CoretechR/ESP32-WiFi-Robot/README.md

# ESP32-WiFi-Robot
ESP32 Powered Video Streaming Robot

My image

Python is needed to convert the website file from HTML to a single string and back.
