CoretechR/ESP32-WiFi-Robot/Eagle Files/ESP32botV1.pdf

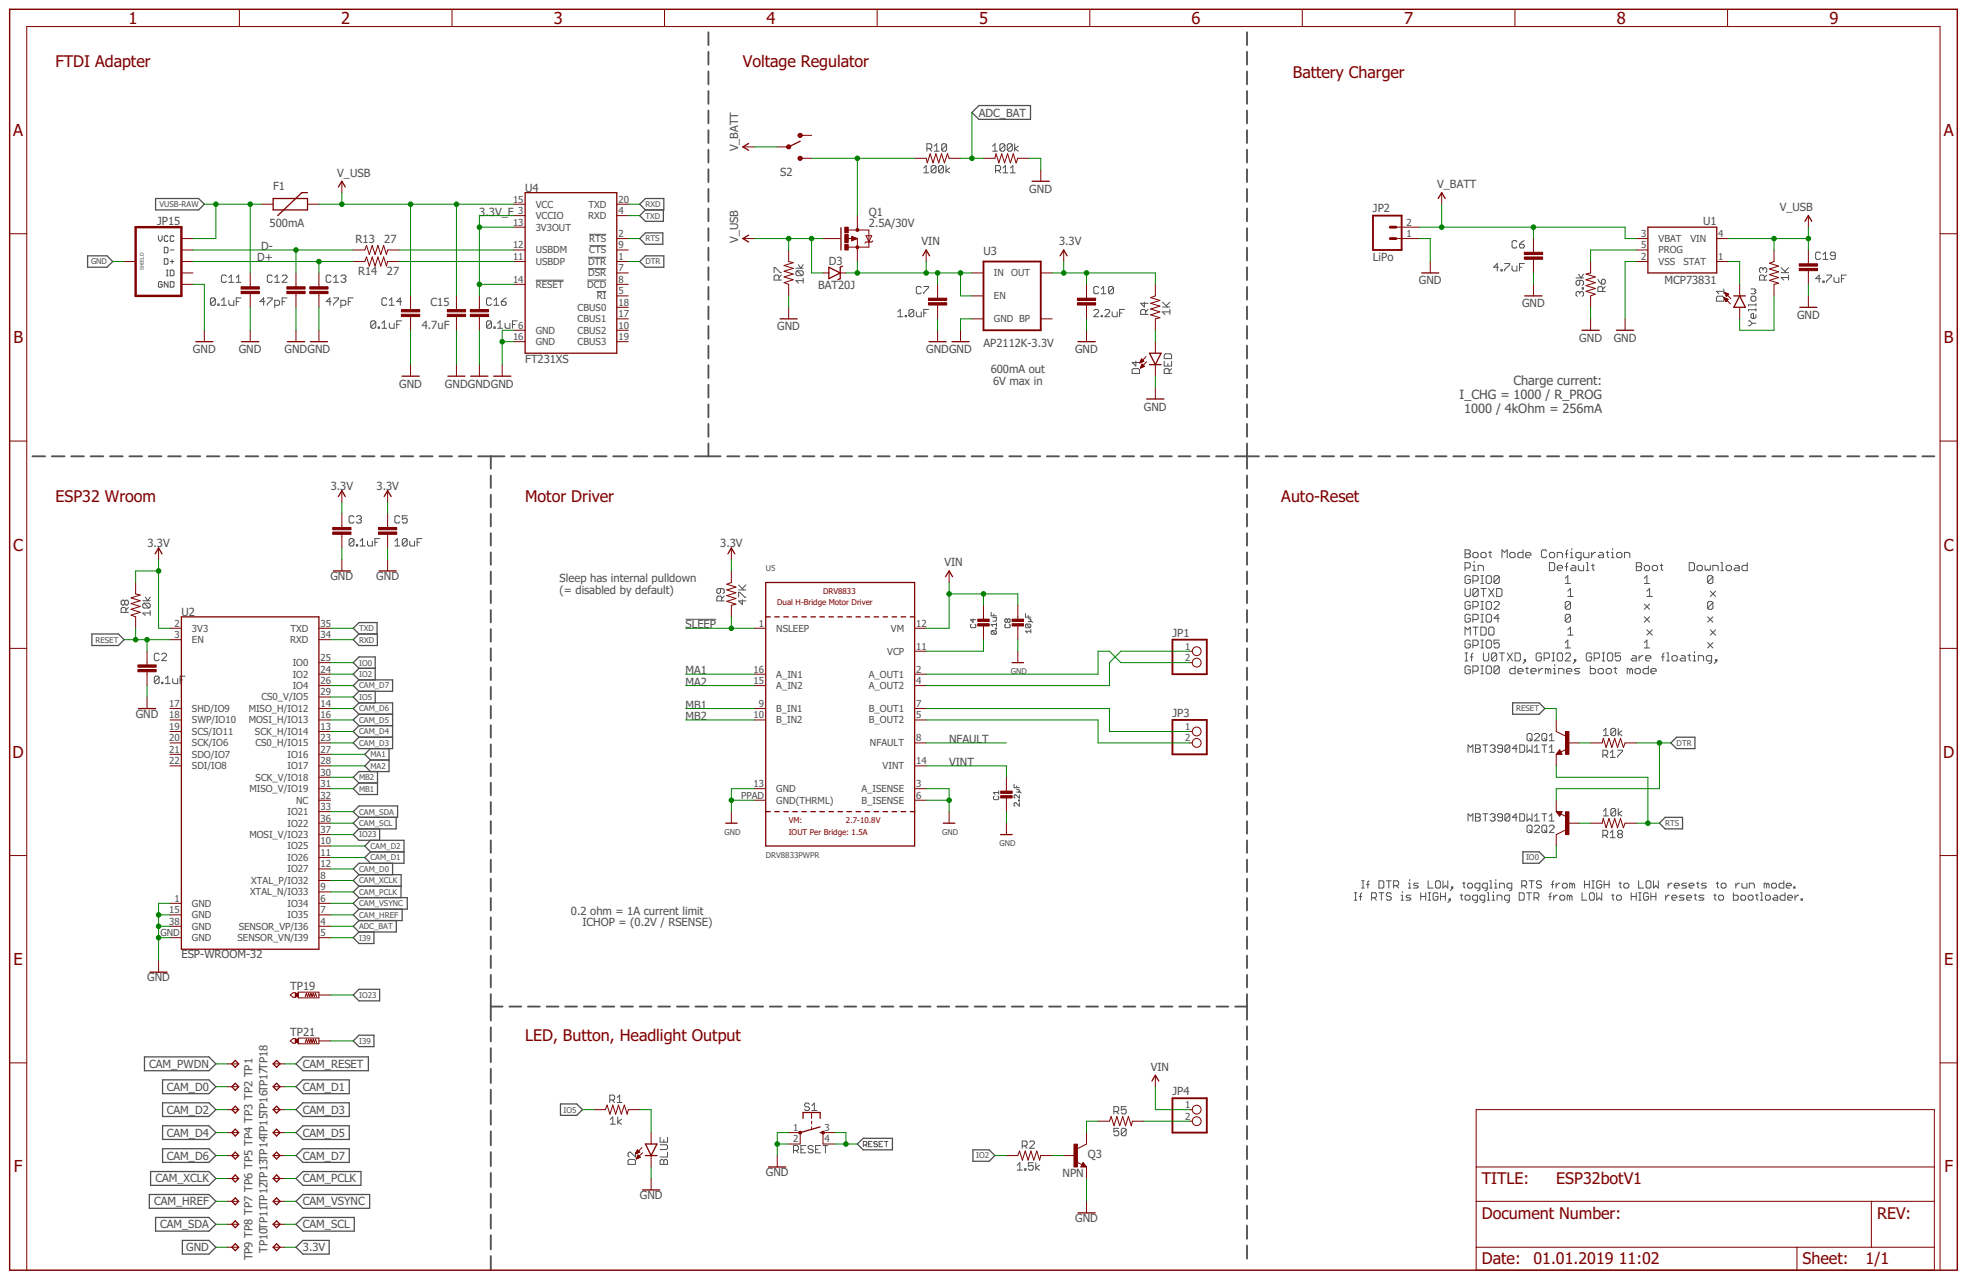
[picture p1: page 1]

Sleep has internal pulldown
(= disabled by default)

DRV8833 Dual H-Bridge Motor Driver

38 | CAM_HREF

0.2 ohm = 1A current limit ICHOP = (0.2V / RSENSE)

LED, Button, Headlight Output

REV: TITLE: Document Number: ESP32botV1
