CoretechR/ESP32-WiFi-Robot/Eagle Files/ESP32botV1.brd

## EAGLE design Eagle Files/ESP32botV1.brd (2019-01-22)

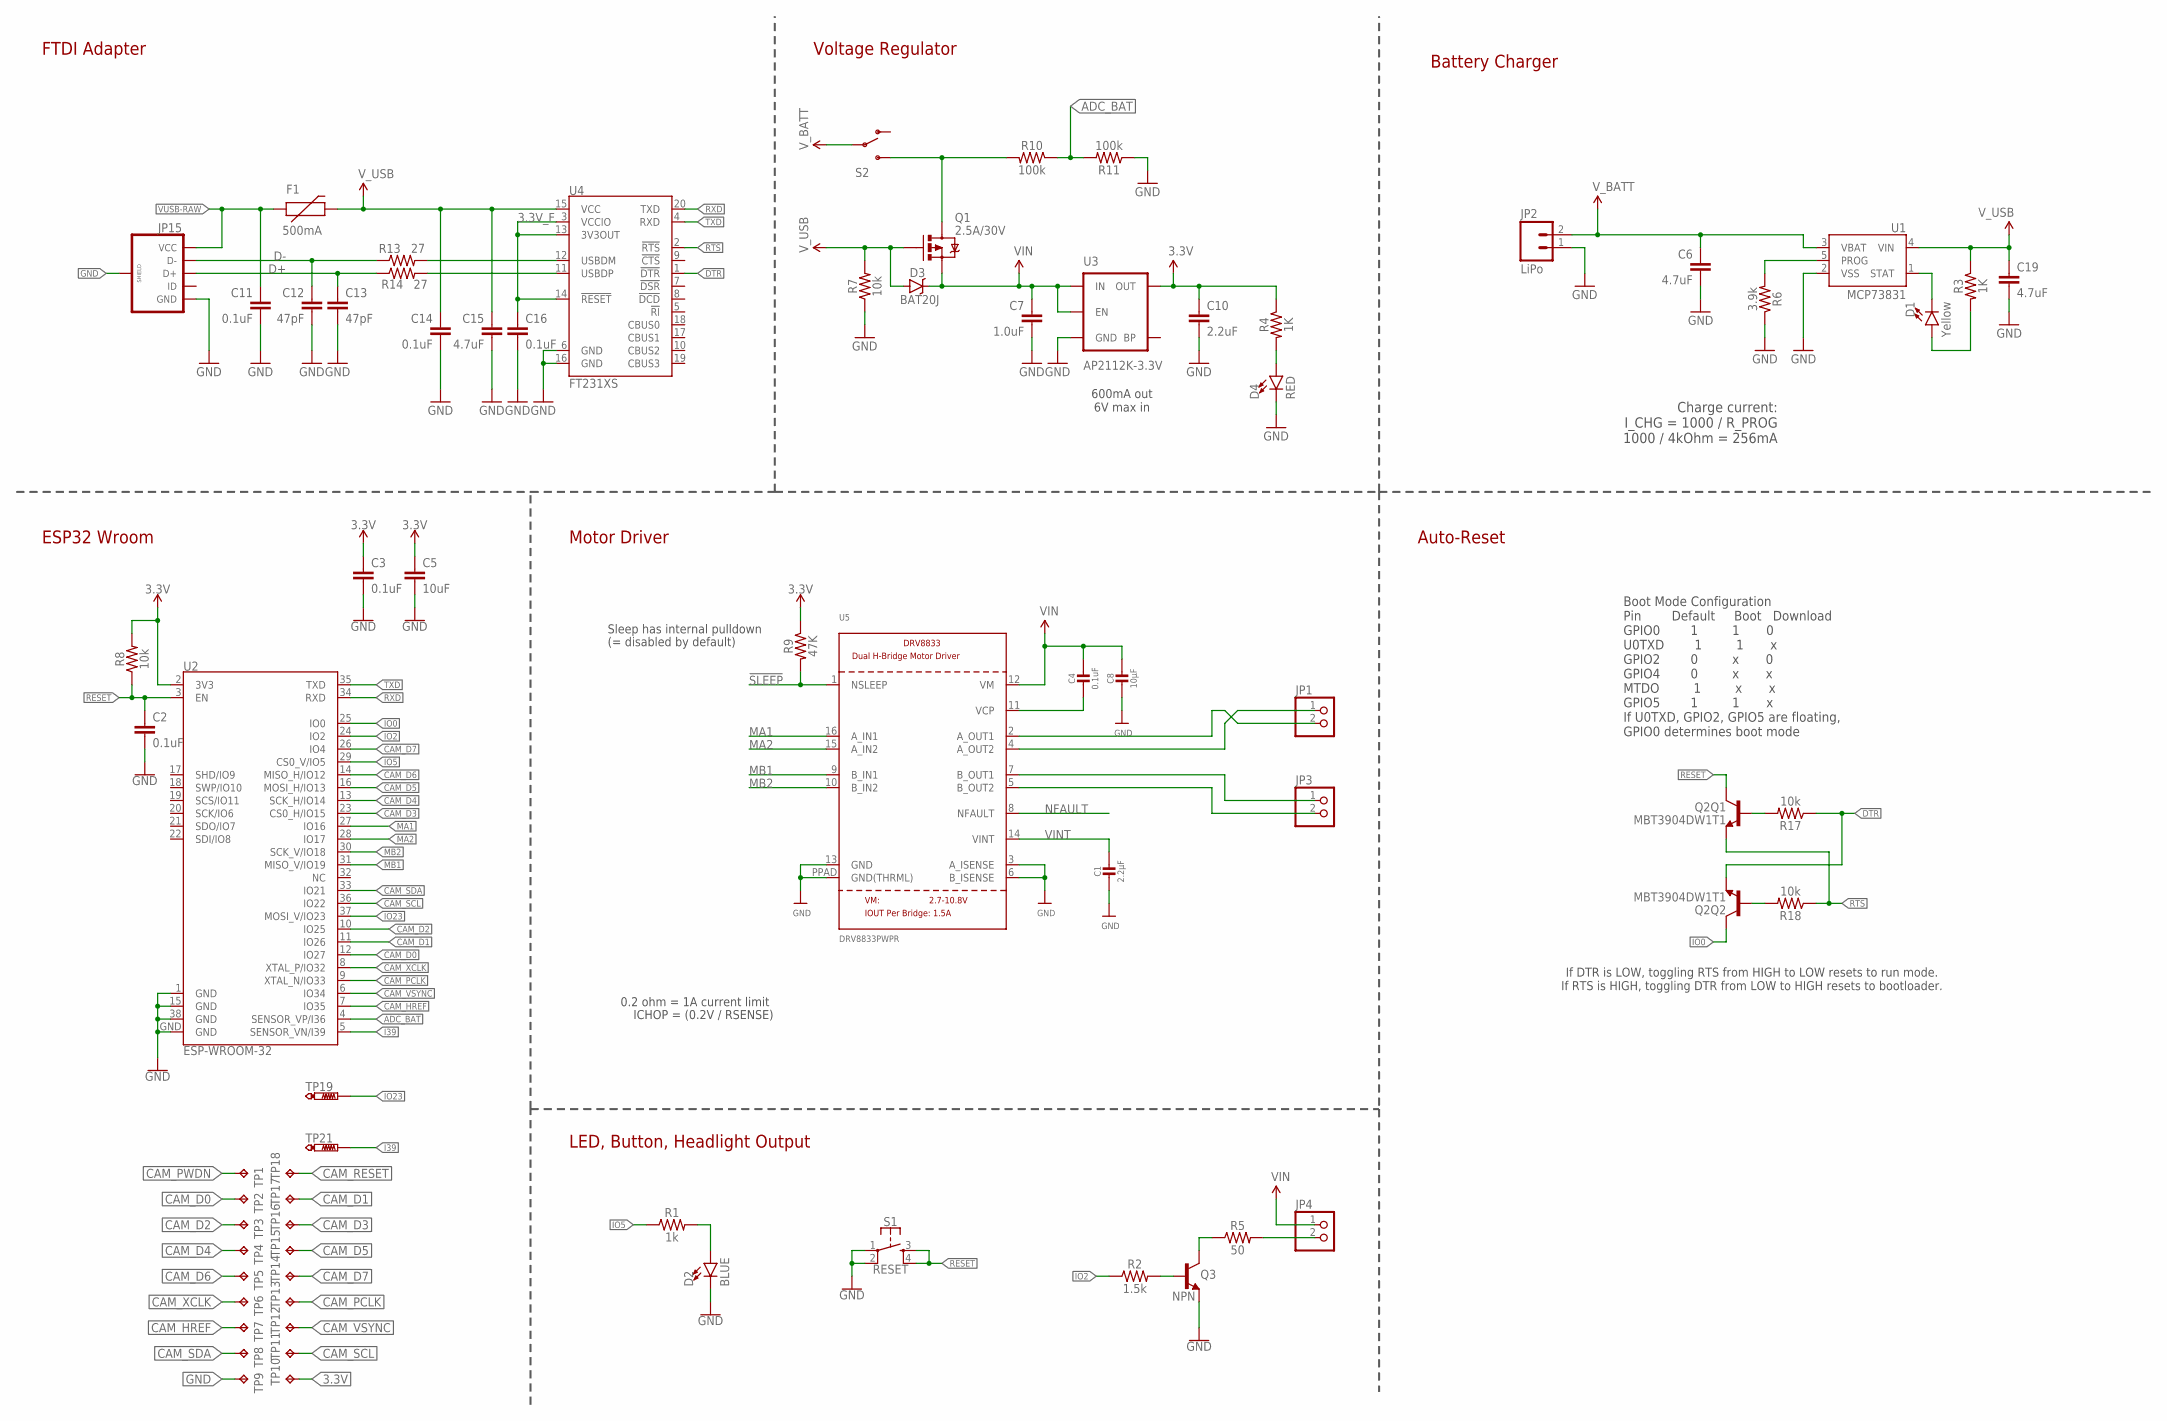
[picture p2: schematic ESP32botV1.sch]

Parts:
C1: 2.2µF; 0805-NO
C2, C3, C11, C14, C16: 0.1uF; 0603
C4: 0.1uF; 0805-NO
C5: 10uF; 0603
C6, C19: 4.7uF; 0603
C7: 1.0uF; 0805
C8: 10µF; 0805-NO
C10: 2.2uF; 0603
C12, C13: 47pF; 0603
C15: 4.7uF; 0603-CAP
D1: Yellow; LED-0603@1
D2: BLUE; LED-0603@2
D3: BAT20J; SOD-323
D4: RED; LED-0603
F1: 500mA; PTC-1206
JP1, JP3, JP4: HEADER-1X2ROUND; 1X02_ROUND
JP2: LiPo; JST-2-PTH
JP15: USB_MICROB_PLUGCONN-11752; USB-B-MICRO-SMD_V03
Q1: 2.5A/30V; SOT23-3
Q2: MBT3904DW1T1; SC70-6
Q3: NPN; SOT23-3
R1: 1k; 0603
R2: 1.5k; 0603
R3, R4: 1K; 0603
R5: 50; 0603
R6: 3.9k; 0603
R7, R8, R17, R18: 10k; 0603
R9: 47K; 0603
R10, R11: 100k; 0603
R13, R14: 27; 0603
S1: RESET; TACTILE_SWITCH_SMD_4.6X2.8MM
S2: SWITCH-SPDT-SMD-A; SWITCH-SPST-SMD-A
TP1, TP2, TP3, TP4, TP5, TP6, TP7, TP8, TP9, TP10, TP11, TP12, TP13, TP14, TP15, TP16, TP17, TP18: TPEC; EDGECONNECTOR
TP19, TP21: PTR1TP13R; TP13R
U1: MCP73831; SOT23-5
U2: ESP-WROOM-32
U3: AP2112K-3.3V; SOT23-5
U4: FT231XS; SSOP20_L
U5: DRV8833PWPR; HTSSOP16

Connections:
3.3V: C3.1, C5.1, C10.1, R4.1, R8.2, R9.1, TP10.TP, U2.2 (3V3), U3.5 (OUT)
3.3V_F: C16.1, U4.3 (VCCIO), U4.13 (3V3OUT), U4.14 (!RESET)
!SLEEP: R9.2, U5.1 (NSLEEP)
ADC_BAT: R10.1, R11.2, U2.4 (SENSOR_VP/I36)
AOUT1: JP1.2, U5.2 (A_OUT1)
AOUT2: JP1.1, U5.4 (A_OUT2)
BOUT1: JP3.1, U5.7 (B_OUT1)
BOUT2: JP3.2, U5.5 (B_OUT2)
CAM_D0: TP2.TP, U2.12 (IO27)
CAM_D1: TP17.TP, U2.11 (IO26)
CAM_D2: TP3.TP, U2.10 (IO25)
CAM_D3: TP16.TP, U2.23 (CS0_H/IO15)
CAM_D4: TP4.TP, U2.13 (SCK_H/IO14)
CAM_D5: TP15.TP, U2.16 (MOSI_H/IO13)
CAM_D6: TP5.TP, U2.14 (MISO_H/IO12)
CAM_D7: TP14.TP, U2.26 (IO4)
CAM_HREF: TP7.TP, U2.7 (IO35)
CAM_PCLK: TP13.TP, U2.9 (XTAL_N/IO33)
CAM_PWDN: TP1.TP
CAM_RESET: TP18.TP
CAM_SCL: TP11.TP, U2.36 (IO22)
CAM_SDA: TP8.TP, U2.33 (IO21)
CAM_VSYNC: TP12.TP, U2.6 (IO34)
CAM_XCLK: TP6.TP, U2.8 (XTAL_P/IO32)
D+: C13.1, JP15.D+, R14.1
D-: C12.1, JP15.D-, R13.1
DTR: Q2.1 (E), R17.1, U4.1 (!DTR)
GND: C1.2, C2.2, C3.2, C5.2, C6.2, C7.2, C8.2, C10.2, C11.2, C12.2, C13.2, C14.2, C15.2, C16.2, C19.2, D2.C, D4.C, JP2.1, JP15.GND, JP15.SHIELD1 (SHIELD), JP15.SHIELD2 (SHIELD), JP15.SHIELD3 (SHIELD), Q3.2 (E), R6.1, R7.1, R11.1, S1.1, S1.2, TP9.TP, U1.2 (VSS), U2.1 (GND), U2.15 (GND), U2.38 (GND), U2.GND, U3.2 (GND), U4.6 (GND), U4.16 (GND), U5.3 (A_ISENSE), U5.6 (B_ISENSE), U5.13 (GND), U5.PPAD (GND(THRML))
I39: TP21.TP, U2.5 (SENSOR_VN/I39)
IO0: Q2.6 (C), U2.25 (IO0)
IO2: R2.1, U2.24 (IO2)
IO5: R1.1, U2.29 (CS0_V/IO5)
IO23: TP19.TP, U2.37 (MOSI_V/IO23)
MA1: U2.27 (IO16), U5.16 (A_IN1)
MA2: U2.28 (IO17), U5.15 (A_IN2)
MB1: U2.31 (MISO_V/IO19), U5.9 (B_IN1)
MB2: U2.30 (SCK_V/IO18), U5.10 (B_IN2)
unnamed: D4.A, R4.2
unnamed: D2.A, R1.2
unnamed: JP4.2, R5.2
unnamed: Q1.3 (D), R10.2, S2.3 (S)
unnamed: R13.2, U4.12 (USBDM)
unnamed: R14.2, U4.11 (USBDP)
unnamed: D1.C, U1.1 (STAT)
unnamed: Q2.5 (B), R17.2
unnamed: Q2.2 (B), R18.2
unnamed: R6.2, U1.5 (PROG)
unnamed: D1.A, R3.2
unnamed: C4.2, U5.11 (VCP)
NFAULT: U5.8 (NFAULT)
OUT1: Q3.3 (C), R5.1
OUT1N: Q3.1 (B), R2.2
RESET: C2.1, Q2.3 (C), R8.1, S1.3, S1.4, U2.3 (EN)
RTS: Q2.4 (E), R18.1, U4.2 (!RTS)
RXD: U2.34 (RXD), U4.20 (TXD)
TXD: U2.35 (TXD), U4.4 (RXD)
VIN: C4.1, C7.1, C8.1, D3.C, JP4.1, Q1.2 (S), U3.1 (IN), U3.3 (EN), U5.12 (VM)
VINT: C1.1, U5.14 (VINT)
VUSB-RAW: C11.1, F1.1, JP15.VBUS (VCC)
V_BATT: C6.1, JP2.2, S2.2, U1.3 (VBAT)
V_USB: C14.1, C15.1, C19.1, D3.A, F1.2, Q1.1 (G), R3.1, R7.2, U1.4 (VIN), U4.15 (VCC)

Notes on the sheet:
Charge current: I_CHG = 1000 / R_PROG 1000 / 4kOhm = 256mA
Boot Mode Configuration Pin Default Boot Download GPIO0 1 1 0 U0TXD 1 1 x GPIO2 0 x 0 GPIO4 0 x x MTDO 1 x x GPIO5 1 1 x If U0TXD, GPIO2, GPIO5 are floating, GPIO0 determines boot mode
Auto-Reset
If DTR is LOW, toggling RTS from HIGH to LOW resets to run mode. If RTS is HIGH, toggling DTR from LOW to HIGH resets to bootloader.
LED, Button, Headlight Output
Voltage Regulator
600mA out 6V max in
0.2 ohm = 1A current limit
ICHOP = (0.2V / RSENSE)
Sleep has internal pulldown
(= disabled by default)
Battery Charger
FTDI Adapter
Motor Driver
ESP32 Wroom

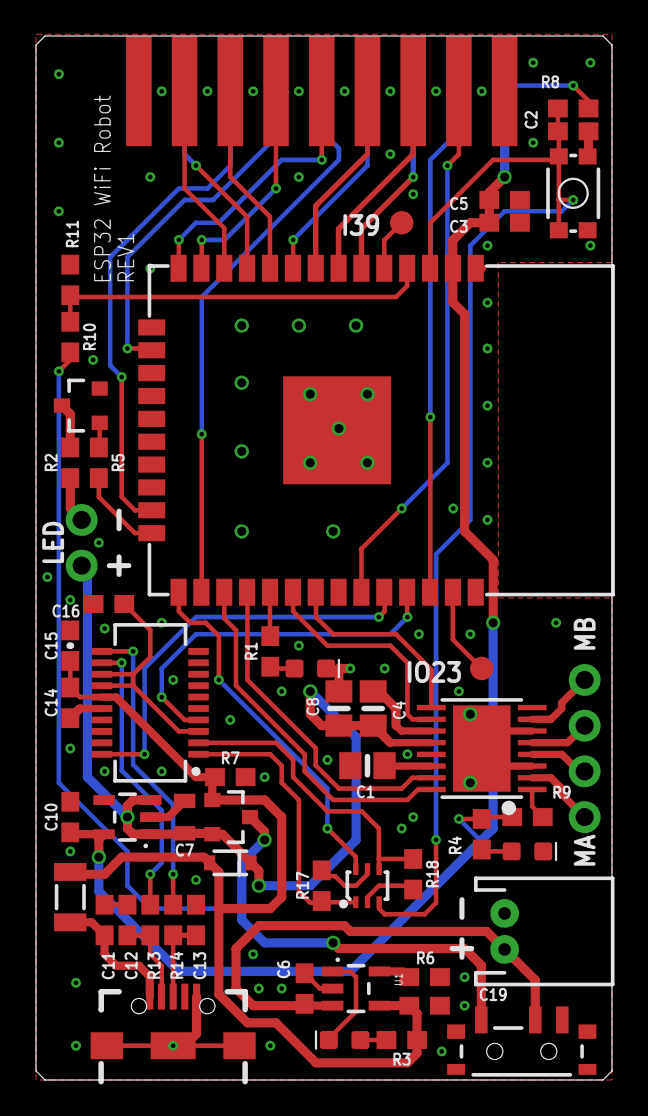
[picture p3: board ESP32botV1.brd from above]

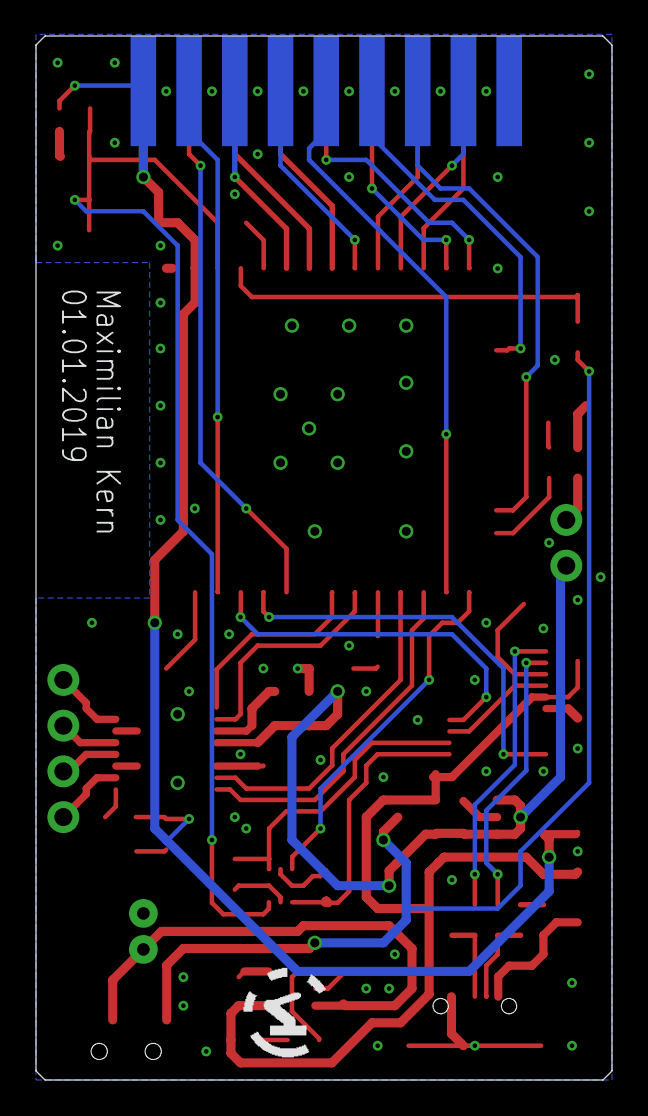
[picture p4: board ESP32botV1.brd from below]

Board: 2 copper layers, 32.0 x 58.0 mm, 71 parts (9 on the bottom side), 58 nets.
