CoretechR/ESP32-WiFi-Robot/ESP32TouchUI/Log.h

#pragma once
#include "Arduino.h"

/*
#define DEBUG_PRINTLN(a) Serial.println(a)
#define DEBUG_PRINT(a) Serial.print(a)
#define DEBUG_PRINTLNF(a, f) Serial.println(a, f)
#define DEBUG_PRINTF(a, f) Serial.print(a, f)
*/
#define DEBUG_PRINTLN(a)
#define DEBUG_PRINT(a)
#define DEBUG_PRINTLNF(a, f)
#define DEBUG_PRINTF(a, f)
