CoretechR/ESP32-WiFi-Robot/ESP32TouchUI/XClk.cpp

//parts of his code are taken from
//https://github.com/igrr/esp32-cam-demo
//by Ivan Grokhotkov
//released under Apache License 2.0

#include "XClk.h"
#include "driver/ledc.h"

bool ClockEnable(int pin, int Hz)
{
    periph_module_enable(PERIPH_LEDC_MODULE);

    ledc_timer_config_t timer_conf;
    timer_conf.bit_num = (ledc_timer_bit_t)1;
    timer_conf.freq_hz = Hz;
    timer_conf.speed_mode = LEDC_HIGH_SPEED_MODE;
    timer_conf.timer_num = LEDC_TIMER_0;
    esp_err_t err = ledc_timer_config(&timer_conf);
    if (err != ESP_OK) {
        return false;
    }

    ledc_channel_config_t ch_conf;
    ch_conf.channel = LEDC_CHANNEL_0;
    ch_conf.timer_sel = LEDC_TIMER_0;
    ch_conf.intr_type = LEDC_INTR_DISABLE;
    ch_conf.duty = 1;
    ch_conf.speed_mode = LEDC_HIGH_SPEED_MODE;
    ch_conf.gpio_num = pin;
    err = ledc_channel_config(&ch_conf);
    if (err != ESP_OK) {
        return false;
    }
    return true;
}

void ClockDisable()
{
    periph_module_disable(PERIPH_LEDC_MODULE);
}
