CoretechR/ESP32-WiFi-Robot/(commit log)

2019-01-22 Eagle files added
    [ESP32botV1.brd, ESP32botV1.sch]
2019-01-27 Schematic PDF added
2019-02-07 Added Image Capture Feature
    The middle button does now save the current image of the stream in 120*160px
